Kevin-jwd/i2c-sensor-driver/README.md

# i2c-sensor-driver

프로젝트 구조와 작업 지침은 [AGENTS.md](AGENTS.md), 확인된 목표와 환경은 [PROJECT.md](PROJECT.md)를 참고하세요. 스타터 설정은 `.ai/`에 있습니다.

## 동작 설명

- [OLED 표시 및 초기화](OLED.md)
- [초음파 거리 측정](ULTRASONIC.md)
- [DHT11 온습도 측정](DHT11.md)
