Kevin-jwd/i2c-sensor-driver/master/master/master.runs/impl_1/.init_design.begin.rst

<?xml version="1.0"?>
<ProcessHandle Version="1" Minor="0">
    <Process Command=".planAhead." Owner="kccistc" Host="DESKTOP-7CFQ9ND" Pid="22824">
    </Process>
</ProcessHandle>
