Kevin-jwd/i2c-sensor-driver/DHT11.md

# DHT11 온습도 센서 동작 과정

Slave 보드에서 DHT11의 DATA 선을 통해 습도와 온도를 읽는다. 구현은 [dht11.v](slave/slave/slave.srcs/sources_1/new/dht11.v), 연결과 자동 시작은 [top_i2c_slave.v](slave/slave/slave.srcs/sources_1/imports/slave/top_i2c_slave.v)에 있다.

## 연결과 기본 설정

| 항목 | 현재 설정 |
| --- | --- |
| DATA | Slave FPGA L3, 양방향 `dht11_data` |
| 통신 | DHT11 전용 단일 데이터선 방식. I²C가 아니며 센서 주소가 없음 |
| FPGA 출력 방식 | 시작 시 LOW, 그 외에는 `Z`로 선을 놓음 |
| 클록 | 기본 `CLK_HZ = 100,000,000`, 내부에서 1 µs tick 생성 |
| 시작 | Top에서 `start`를 1로 고정해 자동 반복 |

DATA가 놓였을 때 HIGH가 되도록 풀업이 필요하다. 3핀 모듈에는 풀업 저항이 이미 있는 경우가 있으므로 모듈 회로를 확인한다. 외부 풀업을 사용할 때는 DHT11 데이터시트에서 짧은 케이블에 권장하는 약 5 kΩ을 참고한다. FPGA DATA 핀의 HIGH 전압은 3.3 V를 초과하지 않아야 하며 센서와 보드의 GND를 공통으로 연결한다.

## 초기화와 측정 순서

리셋하면 온도·습도·오류 값을 0으로 지우고 `WAIT` 상태에서 약 **2.1초** 대기한다. DHT11에 I²C처럼 설정 레지스터나 주소를 보내는 초기화는 없다.

1. **WAIT → IDLE**: 전원 안정 또는 이전 측정 후 대기를 마친다. `start`가 항상 1이므로 다음 측정을 자동으로 시작한다.
2. **START**: FPGA가 DATA를 약 19 ms 동안 LOW로 유지해 측정을 요청한다.
3. **RESPONSE**: FPGA가 DATA를 놓고 센서의 응답 LOW를 기다린다. 코드는 선을 놓은 후 최소 약 5 µs가 지난 시점부터 LOW를 확인한다.
4. **RESPONSE_LOW → RESPONSE_HIGH**: 센서의 약 80 µs LOW, 약 80 µs HIGH 응답이 끝나는 순서대로 상태를 바꾼다.
5. **BIT_LOW → BIT_HIGH**: 각 비트는 약 50 µs LOW 후 HIGH로 전송된다. HIGH가 짧으면 0, 길면 1이며, 코드는 HIGH 시간 카운터가 49 이상이면 1로 판정한다. 이 과정을 40비트에 대해 반복하며 앞에서부터 저장한다.
6. **CHECK**: 앞의 4바이트 합의 하위 8비트와 마지막 체크섬을 비교한다. 같으면 온도와 습도를 갱신하고, 다르면 오류를 기록한다.
7. **WAIT**: 성공이나 실패를 `done`으로 알리고 약 2.1초 대기한 다음 다시 측정한다. 실제 시작 간격은 대기 시간에 통신 시간이 더해진 값이다.

응답이나 데이터 단계에서 신호가 약 200 µs 동안 다음 상태로 바뀌지 않으면 타임아웃 오류로 처리한다. 체크섬 오류 또는 타임아웃이 나면 마지막으로 성공한 온도·습도는 그대로 유지한다. `done`은 완료 시 한 클록 동안 켜지고, `error`는 다음 측정이 시작될 때 지워진다.

## 수신 데이터와 전달

40비트는 아래 순서다. 각 바이트는 상위 비트부터 수신한다.

| 순서 | 내용 | 현재 사용 |
| --- | --- | --- |
| 1 | 습도 정수부 | `humidity`에 저장 |
| 2 | 습도 소수부 | 체크섬 계산에 사용 |
| 3 | 온도 정수부 | `temperature`에 저장 |
| 4 | 온도 소수부 | 체크섬 계산에 사용 |
| 5 | 체크섬 | 앞 4바이트의 합과 비교 |

Slave의 [i2c_slave.v](slave/slave/slave.srcs/sources_1/new/i2c_slave.v)가 Master의 읽기 요청을 받으면 당시 온도·습도·거리를 복사해 4바이트로 보낸다. Master는 이를 기본적으로 약 0.5초마다 읽는다. DHT11 자체의 갱신 주기는 약 2.1초 대기와 통신 시간을 합한 값이므로 Master가 더 자주 읽어도 온습도가 그때마다 새로 측정되는 것은 아니다.

Slave의 FND는 첫 정상 측정 전 온습도를 `---`로 표시한다. 다만 센서 성공 여부는 현재 I²C 데이터에 포함되지 않으므로 Master 화면의 읽기 성공 표시는 DHT11의 정상 측정을 보장하지 않는다.

## Slave LED 확인

| LED | 의미 |
| --- | --- |
| 10 | 리셋 이후 정상 측정이 한 번이라도 있었으면 ON |
| 11 | 마지막 측정이 오류였으면 ON |
| 12 | 측정 시도 완료 때마다 반전 |
| 13 | 현재 DATA 선의 전기적 레벨 |

예를 들어 LED 12가 주기적으로 바뀌고 LED 11이 계속 켜지면 측정 시도는 하지만 마지막 수신이 실패한 상태다. DATA 배선, 공통 GND, 풀업 및 전압을 확인한다.
