Kevin-jwd/i2c-sensor-driver/master/master/master.runs/impl_1/.vivado.begin.rst

<?xml version="1.0"?>
<ProcessHandle Version="1" Minor="0">
    <Process Command="vivado.bat" Owner="kccistc" Host="DESKTOP-7CFQ9ND" Pid="2528" HostCore="16" HostMemory="016847327232">
    </Process>
</ProcessHandle>
