Kevin-jwd/i2c-sensor-driver/OLED.md

# OLED 동작 과정

이 문서는 Master 보드의 SSD1306 128×64 OLED를 현재 코드가 어떻게 초기화하고 갱신하는지 설명한다. 구현은 [oled_ssd1306.v](master/master/master.srcs/sources_1/imports/master/oled_ssd1306.v), 실행 순서와 버스 관리는 [top_i2c_master.v](master/master/master.srcs/sources_1/imports/master/top_i2c_master.v)에 있다.

## 연결과 기본 설정

| 항목 | 현재 설정 |
| --- | --- |
| 화면 | 128×64 픽셀, 8페이지 × 128열 |
| 인터페이스 | I²C, 100 kHz 기본값 |
| OLED 주소 | 7비트 `0x3C`, 쓰기 주소 바이트 `0x78` |
| SDA / SCL | Master의 JA1(J1) / JA2(L2) |
| 공유 버스 | 센서 Slave와 같은 SDA, SCL 사용. Slave 주소는 `0x42` |
| 클록 / 전원 안정 대기 | 기본 100 MHz / 리셋 후 100 ms |

## 거리별 화면

- 첫 Slave 읽기 전에는 기존처럼 `---`를 표시한다.
- 마지막으로 읽은 거리가 **50 cm 이하**이면 온도·습도·거리 화면을 표시한다. FND에도 선택한 센서 값이 표시된다.
- 거리가 **50 cm 초과**이면 OLED는 테두리 안에서 움직이는 16×16 공을 표시한다. 공이 벽에 닿으면 해당 방향이 반전된다. 단색 OLED의 점무늬로 입체감을 표현한다.
- 대기 화면에서도 Slave 센서 측정과 Master 읽기는 계속된다. 50 cm 이내로 접근하면 읽기와 현재 화면 전송이 끝난 뒤 센서 화면으로 돌아간다. FND 표시와 LED는 계속 동작한다.
- 대기 화면은 전체 화면을 연속 전송하며, 센서 읽기 요청은 다음 프레임보다 우선한다. 통신 속도와 센서 읽기에 따라 실제 애니메이션 속도가 결정된다. 화면을 끄거나 먼저 지우지는 않는다.
- 현재 초음파 프로토콜에는 측정 유효 여부가 없어 센서 타임아웃이나 I²C 읽기 실패 시 마지막 거리가 유지될 수 있다. 이때 화면 모드도 이전 값을 기준으로 유지될 수 있다.

SDA와 SCL은 LOW로 당기거나 놓는 방식으로 동작하므로 풀업이 필요하다. OLED와 두 보드의 GND를 공통으로 연결하고, FPGA 핀에는 3.3 V를 초과하는 신호가 들어오지 않게 한다.

## 실행 순서

1. 리셋하면 전원 안정 대기 타이머와 초기화 상태를 지운다. 기본 설정에서 100 ms 뒤 `ready`가 된다.
2. Top에서 OLED 전송을 시작하면 입력된 온도·습도·거리와 유효 상태를 내부에 복사한다. 한 화면을 보내는 도중 센서 값이 바뀌어도 해당 화면에는 복사한 값을 사용한다.
3. 첫 전송에서는 아래 초기화 명령과 화면 주소 범위를 보낸다. 이후 별도 I²C 전송으로 픽셀 데이터를 보낸다.
4. Master가 Slave 읽기에 성공할 때마다 OLED 갱신 요청을 만든다. 대기 화면에서는 애니메이션 프레임도 연속으로 요청한다. 센서 읽기는 기본적으로 0.5초마다 요청하고 버튼으로도 요청할 수 있다. OLED 갱신이 진행 중이면 버스가 비워질 때까지 읽기 요청은 대기한다.
5. 성공적으로 초기화된 이후에는 주소 범위만 다시 지정하고 픽셀 데이터를 덮어쓴다. 갱신할 때마다 화면을 끄거나 전체를 먼저 지우지 않아 깜박임을 줄인다. 전송 도중에는 화면 일부가 먼저 바뀔 수 있다.

## 초기화 명령과 모드

`command(index)`의 인덱스 **0~31은 32개의 전송 바이트**다. 명령에 따라 다음 바이트를 설정값으로 쓰므로 서로 다른 명령 32개라는 뜻은 아니다. 아래는 `HEIGHT=64`일 때 실제 순서다.

| 인덱스 | 전송 바이트 | 설정 |
| --- | --- | --- |
| 0 | `AE` | 화면 OFF |
| 1~2 | `D5 80` | 표시 클록 분주비와 발진 주파수 |
| 3~4 | `A8 3F` | Multiplex 비율 1/64 |
| 5~6 | `D3 00` | 표시 오프셋 0 |
| 7 | `40` | 표시 시작 라인 0 |
| 8~9 | `8D 14` | 내부 Charge Pump 활성화 |
| 10~11 | `20 00` | **Horizontal Addressing Mode** 선택 |
| 12 | `A1` | Segment 방향 재매핑 |
| 13 | `C8` | COM 스캔 방향 재매핑 |
| 14~15 | `DA 12` | 128×64용 COM 핀 구성 |
| 16~17 | `81 8F` | 명암 설정 |
| 18~19 | `D9 F1` | Pre-charge 기간 설정 |
| 20~21 | `DB 40` | VCOMH 레벨 설정 |
| 22 | `A4` | 전체 픽셀 강제 ON 해제, RAM 내용 표시 |
| 23 | `A6` | 일반 표시 모드: 반전하지 않음 |
| 24 | `2E` | 스크롤 비활성화 |
| 25 | `AF` | 화면 ON |
| 26~28 | `21 00 7F` | 열 범위 0~127 |
| 29~31 | `22 00 07` | 페이지 범위 0~7 |

수평 주소 지정 모드에서는 데이터 바이트를 쓰면 열 주소가 증가한다. 지정한 마지막 열 이후에는 다음 페이지의 첫 열로 이동한다. 첫 초기화 후의 일반 갱신에는 위 인덱스 **26~31만** 사용해 주소 범위를 다시 설정한다.

## 화면 데이터 생성과 전송

- `screen_char`가 각 줄의 문자와 숫자 세 자리를 결정한다. 첫 Slave 읽기에 성공하기 전에는 숫자 자리에 `---`를 표시한다.
- `glyph`는 문자를 각각 8×12, 즉 96비트 비트맵으로 직접 정의한다. 각 열은 12비트이며 `enlarged_column`이 해당 열을 읽고 문자 사이에는 빈 열을 둔다.
- 세 줄의 시작 높이는 각각 2, 26, 50픽셀이며 `TEMP`, `HUM`, `DIST`와 단위를 표시한다. 숫자는 앞자리 0을 포함한 세 자리다.
- `pixel`이 문자 모양을 SSD1306의 페이지별 세로 8비트 바이트로 조합한다. 128열 × 8페이지, 총 **1,024바이트**를 전송한다.
- 명령 전송은 `START → 0x78 → 0x00 → 명령 바이트들 → STOP`, 화면 데이터는 `START → 0x78 → 0x40 → 픽셀 바이트들 → STOP` 순서다. `0x00`과 `0x40`은 각각 명령과 데이터임을 나타내는 제어 바이트다.
- 송신 상태기는 `IDLE → START → LOAD → SEND → ACK → STOP`으로 동작한다. 각 바이트 뒤 ACK를 확인하며 NACK가 나면 전송을 종료하고 초기화 상태를 무효화한다. 다음 갱신 요청 때 초기화부터 다시 시도한다.

> 화면의 유효 표시는 Master의 **Slave 읽기 성공 여부**다. DHT11 센서의 측정 성공 여부까지 전달하는 신호는 아니므로, 첫 DHT11 측정 전에도 Slave 읽기에 성공하면 초기값이 표시될 수 있다.
