Kevin-jwd/i2c-sensor-driver/master/master.xdc

# Basys3 Master board
set_property -dict { PACKAGE_PIN W5 IOSTANDARD LVCMOS33 } [get_ports clk]
create_clock -period 10.000 -name clk [get_ports clk]
set_property -dict { PACKAGE_PIN U17 IOSTANDARD LVCMOS33 } [get_ports rst]
set_property -dict { PACKAGE_PIN U18 IOSTANDARD LVCMOS33 } [get_ports start]
set_property -dict { PACKAGE_PIN V17 IOSTANDARD LVCMOS33 } [get_ports {select_sensor[0]}]
set_property -dict { PACKAGE_PIN V16 IOSTANDARD LVCMOS33 } [get_ports {select_sensor[1]}]
# Shared SDA/JA1 and SCL/JA2: connect both Slave and OLED.
# Both lines need suitable external pull-ups to 3.3 V; check module pull-ups.
set_property -dict { PACKAGE_PIN J1 IOSTANDARD LVCMOS33 } [get_ports sda]
set_property -dict { PACKAGE_PIN L2 IOSTANDARD LVCMOS33 } [get_ports scl]
set_property PULLUP true [get_ports sda]
set_property PULLUP true [get_ports scl]
set_property -dict { PACKAGE_PIN W7 IOSTANDARD LVCMOS33 } [get_ports {seg[0]}]
set_property -dict { PACKAGE_PIN W6 IOSTANDARD LVCMOS33 } [get_ports {seg[1]}]
set_property -dict { PACKAGE_PIN U8 IOSTANDARD LVCMOS33 } [get_ports {seg[2]}]
set_property -dict { PACKAGE_PIN V8 IOSTANDARD LVCMOS33 } [get_ports {seg[3]}]
set_property -dict { PACKAGE_PIN U5 IOSTANDARD LVCMOS33 } [get_ports {seg[4]}]
set_property -dict { PACKAGE_PIN V5 IOSTANDARD LVCMOS33 } [get_ports {seg[5]}]
set_property -dict { PACKAGE_PIN U7 IOSTANDARD LVCMOS33 } [get_ports {seg[6]}]
set_property -dict { PACKAGE_PIN V7 IOSTANDARD LVCMOS33 } [get_ports {seg[7]}]
set_property -dict { PACKAGE_PIN U2 IOSTANDARD LVCMOS33 } [get_ports {an[0]}]
set_property -dict { PACKAGE_PIN U4 IOSTANDARD LVCMOS33 } [get_ports {an[1]}]
set_property -dict { PACKAGE_PIN V4 IOSTANDARD LVCMOS33 } [get_ports {an[2]}]
set_property -dict { PACKAGE_PIN W4 IOSTANDARD LVCMOS33 } [get_ports {an[3]}]
set_property -dict { PACKAGE_PIN U16 IOSTANDARD LVCMOS33 } [get_ports {led[0]}]
set_property -dict { PACKAGE_PIN E19 IOSTANDARD LVCMOS33 } [get_ports {led[1]}]
set_property -dict { PACKAGE_PIN U19 IOSTANDARD LVCMOS33 } [get_ports {led[2]}]
set_property -dict { PACKAGE_PIN V19 IOSTANDARD LVCMOS33 } [get_ports {led[3]}]
set_property -dict { PACKAGE_PIN W18 IOSTANDARD LVCMOS33 } [get_ports {led[4]}]
set_property -dict { PACKAGE_PIN U15 IOSTANDARD LVCMOS33 } [get_ports {led[5]}]
set_property -dict { PACKAGE_PIN U14 IOSTANDARD LVCMOS33 } [get_ports {led[6]}]
set_property -dict { PACKAGE_PIN V14 IOSTANDARD LVCMOS33 } [get_ports {led[7]}]
set_property -dict { PACKAGE_PIN V13 IOSTANDARD LVCMOS33 } [get_ports {led[8]}]
set_property -dict { PACKAGE_PIN V3 IOSTANDARD LVCMOS33 } [get_ports {led[9]}]
set_property -dict { PACKAGE_PIN W3 IOSTANDARD LVCMOS33 } [get_ports {led[10]}]
set_property -dict { PACKAGE_PIN U3 IOSTANDARD LVCMOS33 } [get_ports {led[11]}]
set_property -dict { PACKAGE_PIN P3 IOSTANDARD LVCMOS33 } [get_ports {led[12]}]
set_property -dict { PACKAGE_PIN N3 IOSTANDARD LVCMOS33 } [get_ports {led[13]}]
set_property -dict { PACKAGE_PIN P1 IOSTANDARD LVCMOS33 } [get_ports {led[14]}]
set_property -dict { PACKAGE_PIN L1 IOSTANDARD LVCMOS33 } [get_ports {led[15]}]
