Kevin-jwd/i2c-sensor-driver/master/master/master.runs/synth_1/.Xil/top_i2c_master_propImpl.xdc

set_property SRC_FILE_INFO {cfile:D:/projects/i2c-sensor-driver/master/master/master.srcs/constrs_1/imports/digilent-xdc-master/Basys3-Master_orginal.xdc rfile:../../../master.srcs/constrs_1/imports/digilent-xdc-master/Basys3-Master_orginal.xdc id:1} [current_design]
set_property src_info {type:XDC file:1 line:163 export:INPUT save:INPUT read:READ} [current_design]
set_property -dict { PACKAGE_PIN W5 IOSTANDARD LVCMOS33 } [get_ports clk]
set_property src_info {type:XDC file:1 line:165 export:INPUT save:INPUT read:READ} [current_design]
set_property -dict { PACKAGE_PIN U17 IOSTANDARD LVCMOS33 } [get_ports rst]
set_property src_info {type:XDC file:1 line:166 export:INPUT save:INPUT read:READ} [current_design]
set_property -dict { PACKAGE_PIN U18 IOSTANDARD LVCMOS33 } [get_ports start]
set_property src_info {type:XDC file:1 line:167 export:INPUT save:INPUT read:READ} [current_design]
set_property -dict { PACKAGE_PIN V17 IOSTANDARD LVCMOS33 } [get_ports {select_sensor[0]}]
set_property src_info {type:XDC file:1 line:168 export:INPUT save:INPUT read:READ} [current_design]
set_property -dict { PACKAGE_PIN V16 IOSTANDARD LVCMOS33 } [get_ports {select_sensor[1]}]
set_property src_info {type:XDC file:1 line:170 export:INPUT save:INPUT read:READ} [current_design]
set_property -dict { PACKAGE_PIN J1 IOSTANDARD LVCMOS33 } [get_ports sda]
set_property src_info {type:XDC file:1 line:171 export:INPUT save:INPUT read:READ} [current_design]
set_property -dict { PACKAGE_PIN L2 IOSTANDARD LVCMOS33 } [get_ports scl]
set_property src_info {type:XDC file:1 line:174 export:INPUT save:INPUT read:READ} [current_design]
set_property -dict { PACKAGE_PIN W7 IOSTANDARD LVCMOS33 } [get_ports {seg[0]}]
set_property src_info {type:XDC file:1 line:175 export:INPUT save:INPUT read:READ} [current_design]
set_property -dict { PACKAGE_PIN W6 IOSTANDARD LVCMOS33 } [get_ports {seg[1]}]
set_property src_info {type:XDC file:1 line:176 export:INPUT save:INPUT read:READ} [current_design]
set_property -dict { PACKAGE_PIN U8 IOSTANDARD LVCMOS33 } [get_ports {seg[2]}]
set_property src_info {type:XDC file:1 line:177 export:INPUT save:INPUT read:READ} [current_design]
set_property -dict { PACKAGE_PIN V8 IOSTANDARD LVCMOS33 } [get_ports {seg[3]}]
set_property src_info {type:XDC file:1 line:178 export:INPUT save:INPUT read:READ} [current_design]
set_property -dict { PACKAGE_PIN U5 IOSTANDARD LVCMOS33 } [get_ports {seg[4]}]
set_property src_info {type:XDC file:1 line:179 export:INPUT save:INPUT read:READ} [current_design]
set_property -dict { PACKAGE_PIN V5 IOSTANDARD LVCMOS33 } [get_ports {seg[5]}]
set_property src_info {type:XDC file:1 line:180 export:INPUT save:INPUT read:READ} [current_design]
set_property -dict { PACKAGE_PIN U7 IOSTANDARD LVCMOS33 } [get_ports {seg[6]}]
set_property src_info {type:XDC file:1 line:181 export:INPUT save:INPUT read:READ} [current_design]
set_property -dict { PACKAGE_PIN V7 IOSTANDARD LVCMOS33 } [get_ports {seg[7]}]
set_property src_info {type:XDC file:1 line:182 export:INPUT save:INPUT read:READ} [current_design]
set_property -dict { PACKAGE_PIN U2 IOSTANDARD LVCMOS33 } [get_ports {an[0]}]
set_property src_info {type:XDC file:1 line:183 export:INPUT save:INPUT read:READ} [current_design]
set_property -dict { PACKAGE_PIN U4 IOSTANDARD LVCMOS33 } [get_ports {an[1]}]
set_property src_info {type:XDC file:1 line:184 export:INPUT save:INPUT read:READ} [current_design]
set_property -dict { PACKAGE_PIN V4 IOSTANDARD LVCMOS33 } [get_ports {an[2]}]
set_property src_info {type:XDC file:1 line:185 export:INPUT save:INPUT read:READ} [current_design]
set_property -dict { PACKAGE_PIN W4 IOSTANDARD LVCMOS33 } [get_ports {an[3]}]
set_property src_info {type:XDC file:1 line:186 export:INPUT save:INPUT read:READ} [current_design]
set_property -dict { PACKAGE_PIN U16 IOSTANDARD LVCMOS33 } [get_ports {led[0]}]
set_property src_info {type:XDC file:1 line:187 export:INPUT save:INPUT read:READ} [current_design]
set_property -dict { PACKAGE_PIN E19 IOSTANDARD LVCMOS33 } [get_ports {led[1]}]
set_property src_info {type:XDC file:1 line:188 export:INPUT save:INPUT read:READ} [current_design]
set_property -dict { PACKAGE_PIN U19 IOSTANDARD LVCMOS33 } [get_ports {led[2]}]
set_property src_info {type:XDC file:1 line:189 export:INPUT save:INPUT read:READ} [current_design]
set_property -dict { PACKAGE_PIN V19 IOSTANDARD LVCMOS33 } [get_ports {led[3]}]
set_property src_info {type:XDC file:1 line:190 export:INPUT save:INPUT read:READ} [current_design]
set_property -dict { PACKAGE_PIN W18 IOSTANDARD LVCMOS33 } [get_ports {led[4]}]
set_property src_info {type:XDC file:1 line:191 export:INPUT save:INPUT read:READ} [current_design]
set_property -dict { PACKAGE_PIN U15 IOSTANDARD LVCMOS33 } [get_ports {led[5]}]
set_property src_info {type:XDC file:1 line:192 export:INPUT save:INPUT read:READ} [current_design]
set_property -dict { PACKAGE_PIN U14 IOSTANDARD LVCMOS33 } [get_ports {led[6]}]
set_property src_info {type:XDC file:1 line:193 export:INPUT save:INPUT read:READ} [current_design]
set_property -dict { PACKAGE_PIN V14 IOSTANDARD LVCMOS33 } [get_ports {led[7]}]
set_property src_info {type:XDC file:1 line:194 export:INPUT save:INPUT read:READ} [current_design]
set_property -dict { PACKAGE_PIN V13 IOSTANDARD LVCMOS33 } [get_ports {led[8]}]
set_property src_info {type:XDC file:1 line:195 export:INPUT save:INPUT read:READ} [current_design]
set_property -dict { PACKAGE_PIN V3 IOSTANDARD LVCMOS33 } [get_ports {led[9]}]
set_property src_info {type:XDC file:1 line:196 export:INPUT save:INPUT read:READ} [current_design]
set_property -dict { PACKAGE_PIN W3 IOSTANDARD LVCMOS33 } [get_ports {led[10]}]
set_property src_info {type:XDC file:1 line:197 export:INPUT save:INPUT read:READ} [current_design]
set_property -dict { PACKAGE_PIN U3 IOSTANDARD LVCMOS33 } [get_ports {led[11]}]
set_property src_info {type:XDC file:1 line:198 export:INPUT save:INPUT read:READ} [current_design]
set_property -dict { PACKAGE_PIN P3 IOSTANDARD LVCMOS33 } [get_ports {led[12]}]
set_property src_info {type:XDC file:1 line:199 export:INPUT save:INPUT read:READ} [current_design]
set_property -dict { PACKAGE_PIN N3 IOSTANDARD LVCMOS33 } [get_ports {led[13]}]
set_property src_info {type:XDC file:1 line:200 export:INPUT save:INPUT read:READ} [current_design]
set_property -dict { PACKAGE_PIN P1 IOSTANDARD LVCMOS33 } [get_ports {led[14]}]
set_property src_info {type:XDC file:1 line:201 export:INPUT save:INPUT read:READ} [current_design]
set_property -dict { PACKAGE_PIN L1 IOSTANDARD LVCMOS33 } [get_ports {led[15]}]
