Kevin-jwd/i2c-sensor-driver/(commit log)

2026-11-04 chore: OLED 글꼴 개선 및 프로젝트 문서·Vivado 산출물 갱신
2026-11-05 feat: 휴면 상태 애니메이션 추가 및 전반적인 코드 리팩터링
